Pato01010/ECE455_MAG5_captsone-project/Tests/powerboard photos/12V_TP1.JPG

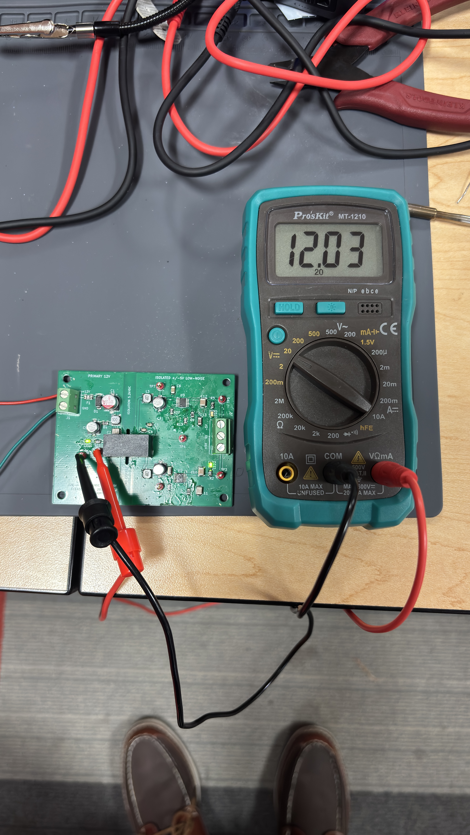
Tests/powerboard photos/12V_TP1.JPG
