Pato01010/ECE455_MAG5_captsone-project/hardware/design_files/analog_amp/magnetometer_amp.png

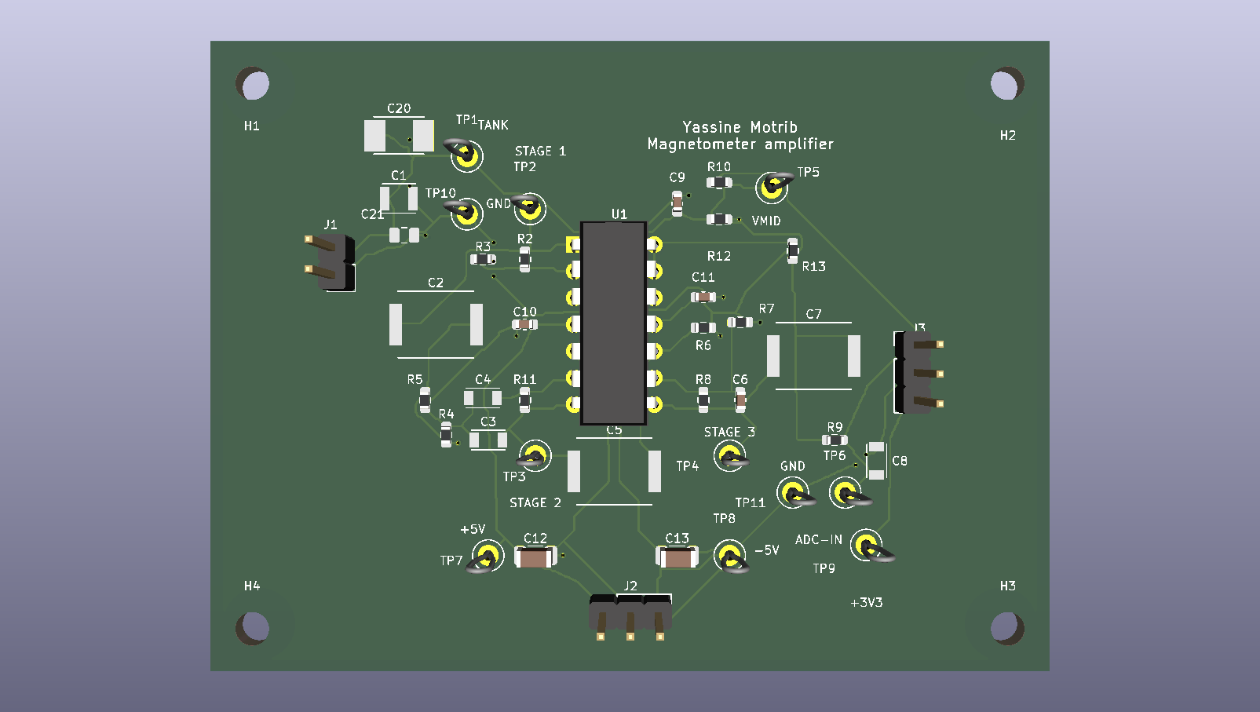
hardware/design_files/analog_amp/magnetometer_amp.png
