Pato01010/ECE455_MAG5_captsone-project/hardware/design_files/polarization_switch/polarization_switch_rev_E_3D.png

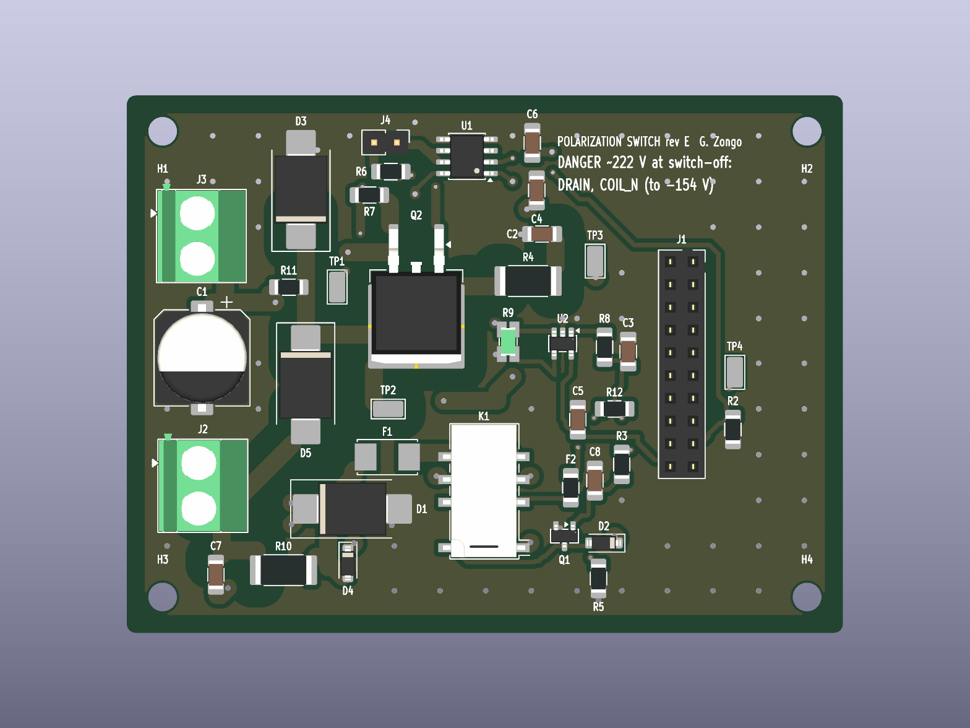
hardware/design_files/polarization_switch/polarization_switch_rev_E_3D.png
