Pato01010/ECE455_MAG5_captsone-project/hardware/design_files/power_board/MEJ2D1205SC 112V to ±5V.png

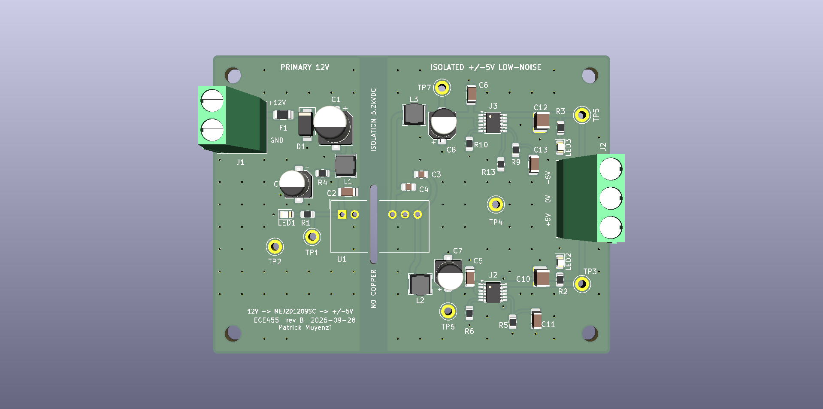
hardware/design_files/power_board/MEJ2D1205SC 112V to ±5V.png
