Pato01010/ECE455_MAG5_captsone-project/hardware/BOM/12V to ±5V converter.xlsx

Isolated ±5 V power board Rev B - bill of materials
# | References | Qty | Value | Part number | Digi-Key (qty 1)
1 | U1 | 1 | MEJ2D1209SC | MEJ2D1209SC (Murata) | 811-2407-ND
2 | U2 | 1 | LT3045 | LT3045EMSE#PBF (Analog Devices) | 505-LT3045EMSE#PBF-ND (tube, sold from 1)
3 | U3 | 1 | LT3094 | LT3094EMSE#PBF (Analog Devices) | 505-LT3094EMSE#PBF-ND (tube, sold from 1)
4 | D1 | 1 | SMAJ15A | SMAJ15A (Littelfuse) | SMAJ15ALFCT-ND
5 | LED1, LED2, LED3 | 3 | Green | LTST-C170KGKT (Lite-On) | 160-1414-1-ND
6 | C1 | 1 | 47u/50V alu | 865080645012 (Würth Elektronik) | 732-8457-1-ND
7 | C2, C11, C13 | 3 | 4.7u/25V | GRM31CR71E475KA88L (Murata) | 490-1809-1-ND
8 | C3, C4 | 2 | 1u/25V | GRM21BR71E105KA99L (Murata) | 490-6484-1-ND
9 | C5, C6 | 2 | 10u/16V | C1206C106K4RAC7215 (KEMET) | 399-C1206C106K4RAC7215CT-ND
10 | C7, C8, C9 | 3 | 22u/25V alu | UCL1E220MCL1GS (Nichicon) | 493-3932-1-ND
11 | C10, C12 | 2 | 22u/25V X7R | CL32B226KAJNNNE (Samsung) | 1276-3392-1-ND (backorder; or GRM32ER71E226KE15L, 490-5313-1-ND)
12 | L1 | 1 | 10uH | SRN4018-100M (Bourns) | SRN4018-100MCT-ND
13 | L2, L3 | 2 | 4.7uH | SRN4018-4R7M (Bourns) | SRN4018-4R7MCT-ND
14 | R1 | 1 | 4.7k | RC0805FR-074K7L (Yageo) | 311-4.70KCRCT-ND
15 | R2, R3 | 2 | 1k | RC0805FR-071KL (Yageo) | 311-1.00KCRCT-ND
16 | R4 | 1 | 0.47 | ERJ-6RQFR47V (Panasonic) | P.47DCT-ND
17 | R5, R9 | 2 | 49.9k 0.1% | ERA-6AEB4992V (Panasonic) | P49.9KDACT-ND
18 | R6 | 1 | 499 | RC0805FR-07499RL (Yageo) | 311-499CRCT-ND
19 | R10 | 1 | 3.74k | RC0805FR-073K74L (Yageo) | 311-3.74KCRCT-ND
20 | R13 | 1 | 100k | RC0805FR-07100KL (Yageo) | 311-100KCRCT-ND
21 | F1 | 1 | 0.5A PTC | SMDH1206B050TF (Yageo) | 13-SMDH1206B050TFCT-ND
22 | J1 | 1 | 12V IN | 1729128 (Phoenix Contact) | 277-1247-ND
23 | J2 | 1 | ±5V OUT | 1729131 (Phoenix Contact) | 277-1248-ND
24 | TP1-TP7 | 7 | VIN_MOD / GND / +5V / ISO_0V / -5V / +9V_F / -9V_F | 5010 (Keystone) | 36-5010-ND
