Pato01010/ECE455_MAG5_captsone-project/hardware/design_files/polarization_switch/polarization_switch_rev_E_BOM.xlsx

Polarization switch Rev E - bill of materials
# | References | Qty | Value | Part number | Digi-Key (qty 1)
1 | D1, D5 | 2 | MURS360 | MURS360-E3/57T (Vishay) | MURS360-E3/57TGICT-ND
2 | D2, D4 | 2 | 1N4148W | 1N4148W-7-F (Diodes Inc) | 1N4148W-FDICT-ND
3 | D3 | 1 | 1.5SMC200A | 1.5SMC200A (Littelfuse) | 1.5SMC200ACT-ND
4 | Q2 | 1 | R6020KNJ | R6020KNJTL (Rohm) | R6020KNJTLCT-ND
5 | Q1 | 1 | MMBT3904 | MMBT3904-7-F (Diodes Inc) | MMBT3904-FDICT-ND
6 | K1 | 1 | G6S-2F DC12 | G6S-2F DC12 (Omron) | Z889-ND (tube, sold from 1)
7 | U1 | 1 | MCP1407-E/SN | MCP1407-E/SN (Microchip) | MCP1407-E/SN-ND (tube, sold from 1)
8 | U2 | 1 | INA180A2 | INA180A2IDBVR (TI) | 296-47653-1-ND
9 | C5, C6 | 2 | 100n | C1206C104K5RACTU (KEMET) | 399-C1206C104K5RACTUCT-ND
10 | C1 | 1 | 470u/25V | EEE-FK1E471P (Panasonic) | PCE3805CT-ND
11 | C3 | 1 | 10n C0G | C1206C103J5GACTU (KEMET) | 399-C1206C103J5GACTUCT-ND
12 | C2, C7 | 2 | 1n/630V | GRM31B5C2J102JW01L (Murata) | 490-5279-1-ND
13 | C4 | 1 | 2.2u/50V | CL31B225KBHNNNE (Samsung) | 1276-1291-1-ND
14 | C8 | 1 | 10u | GRM31CR71E106KA12L (Murata) | 490-6518-1-ND
15 | R8 | 1 | 1k | RC1206FR-071KL (Yageo) | 311-1.00KFRCT-ND
16 | R6 | 1 | 47 | RMCF1206FT47R0 (Stackpole) | RMCF1206FT47R0CT-ND
17 | R2, R5, R7 | 3 | 10k | RC1206FR-0710KL (Yageo) | 311-10.0KFRCT-ND
18 | R3 | 1 | 2.2k | RC1206FR-072K2L (Yageo) | 311-2.20KFRCT-ND
19 | R9 | 1 | 20m | LVK12R020DER (Ohmite) | 273-LVK12R020DERCT-ND
20 | R4 | 1 | 10k | CRGP2512F10K (TE Connectivity) | A130733CT-ND
21 | R10 | 1 | 22k | CRGP2512F22K (TE Connectivity) | A130737CT-ND
22 | R11 | 1 | 1M | KTR18EZPF1004 (Rohm) | RHM1MAICT-ND
23 | R12 | 1 | 18 | RC1206FR-0718RL (Yageo) | 311-18.0FRCT-ND
24 | F2 | 1 | 125mA F | 0466.125NR (Littelfuse) | F1450CT-ND
25 | F1 | 1 | 2A T | 0157002.DRT (Littelfuse)
26 | J4 | 1 | GATE LINK | PREC002SAAN-RC + SPC02SYAN shunt (Sullins) | S1012EC-02-ND + S9001-ND
27 | J1 | 1 | 2x10 stack | PPPC102LFBN-RC (Sullins) | S6106-ND
28 | J2 | 1 | COIL | 1715721 (Phoenix Contact) | 277-1263-ND
29 | J3 | 1 | 12V IN | 1715721 (Phoenix Contact) | 277-1263-ND
30 | TP1-TP4 | 4 | GATE / DRAIN / SRC / I_SENSE | 5015 (Keystone) | 36-5015CT-ND
 | Line items | 30
 | Parts | 39
