Pato01010/ECE455_MAG5_captsone-project/mechanical/3D wire container/cap_fit_tight_0p2mm.stl

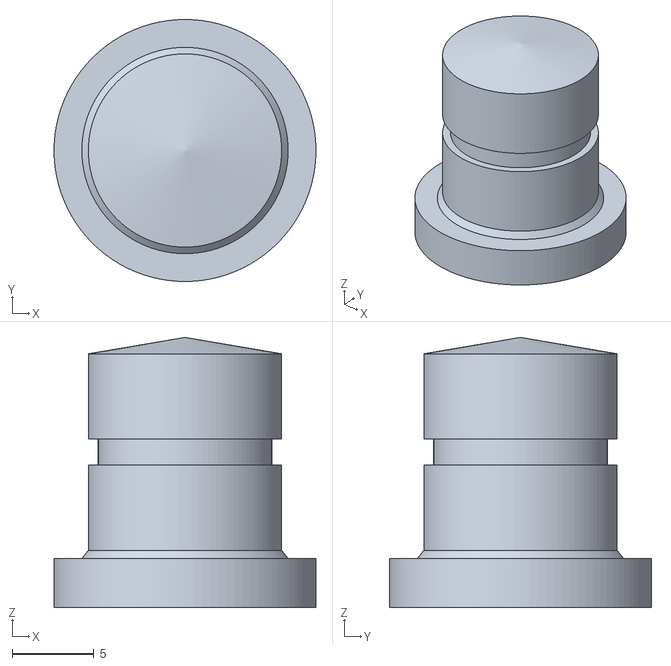
[picture p6: CAD file, 2026-10-30]
mechanical/3D wire container/cap_fit_tight_0p2mm.stl
16.0 x 16.0 x 16.5
