Pato01010/ECE455_MAG5_captsone-project/mechanical/part1_body_wide_base.stl

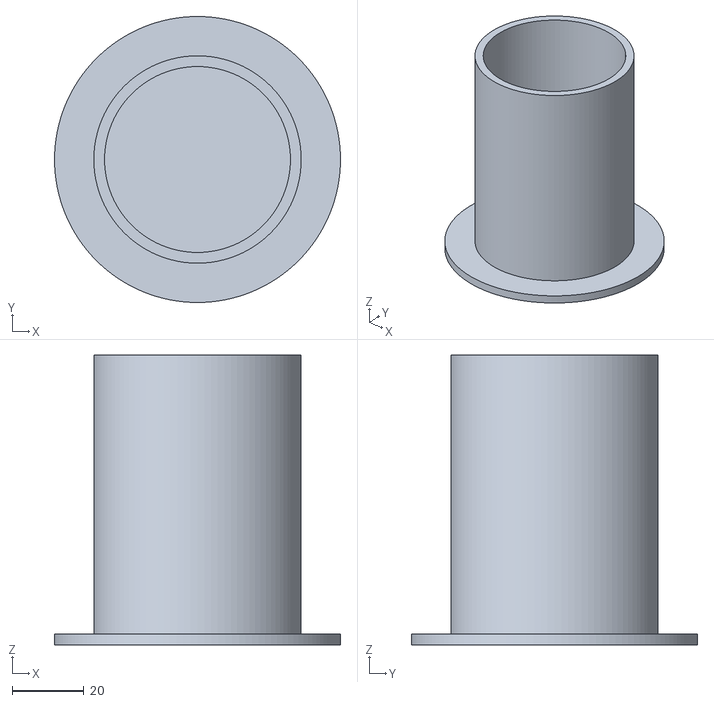
[picture p7: CAD file, 2026-10-30]
mechanical/part1_body_wide_base.stl
80.0 x 80.0 x 81.0
