Pato01010/ECE455_MAG5_captsone-project/mechanical/3D wire container/cap_fit_loose_1p4mm.stl

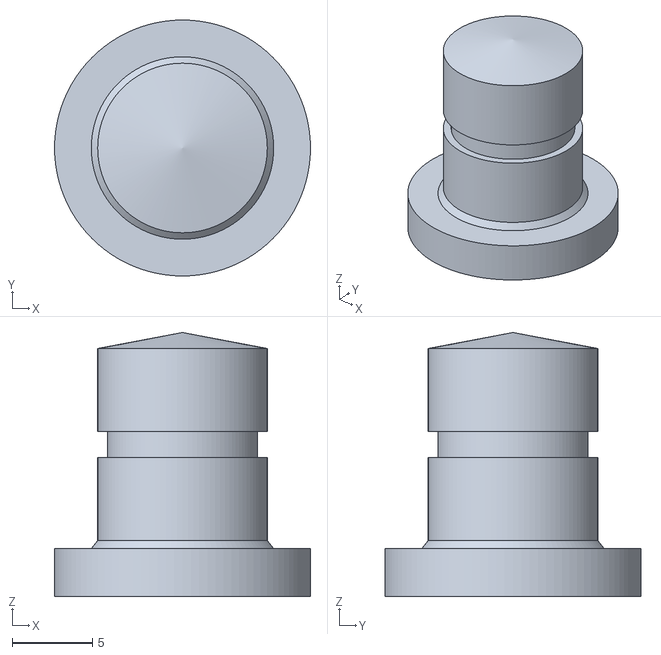
[picture p8: CAD file, 2026-10-30]
mechanical/3D wire container/cap_fit_loose_1p4mm.stl
16.0 x 16.0 x 16.5
