Pato01010/ECE455_MAG5_captsone-project/mechanical/3D wire container/part2_flat_disc_with_neck.stl

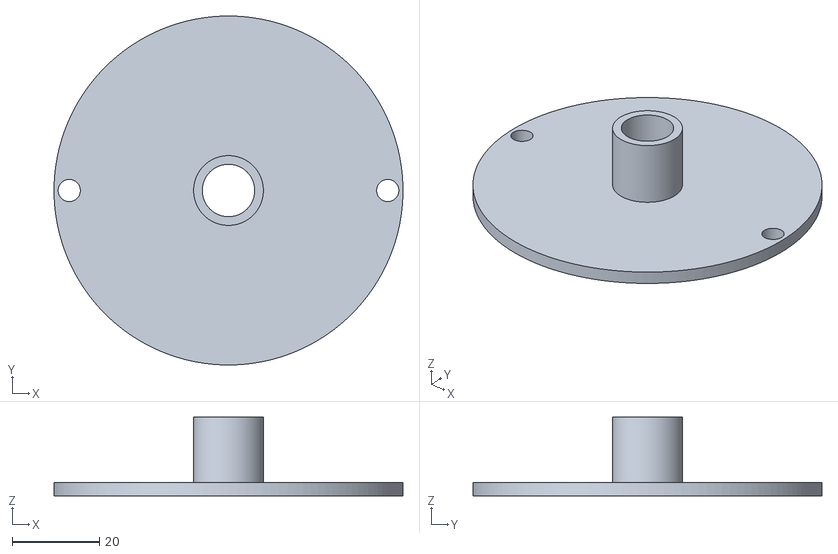
[picture p9: CAD file, 2026-10-30]
mechanical/3D wire container/part2_flat_disc_with_neck.stl
80.0 x 80.0 x 18.0
