Pato01010/ECE455_MAG5_captsone-project/(list of files, cad)

Other CAD files:
mechanical/cap_fit_medium_1p0mm.stl
mechanical/3D wire container/cap_fit_snug_0p6mm.stl
