Pato01010/ECE455_MAG5_captsone-project/Tests/powerboard photos/final assembled pcb.jpg

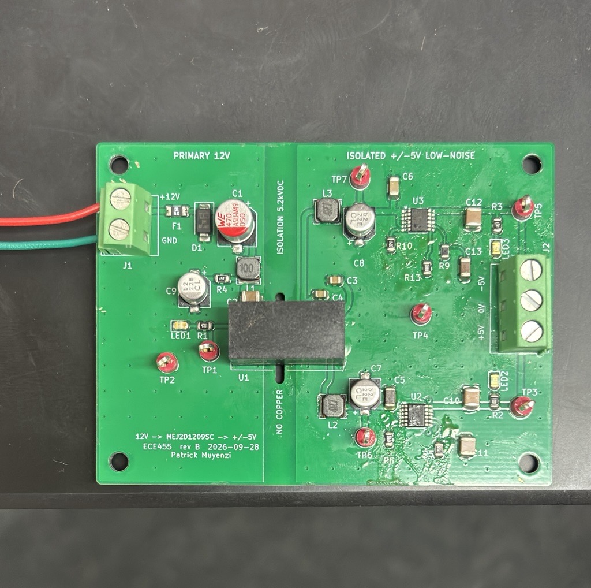
Tests/powerboard photos/final assembled pcb.jpg
