Pato01010/ECE455_MAG5_captsone-project/LTSpice Simulations/powerboard/results ±5V.png

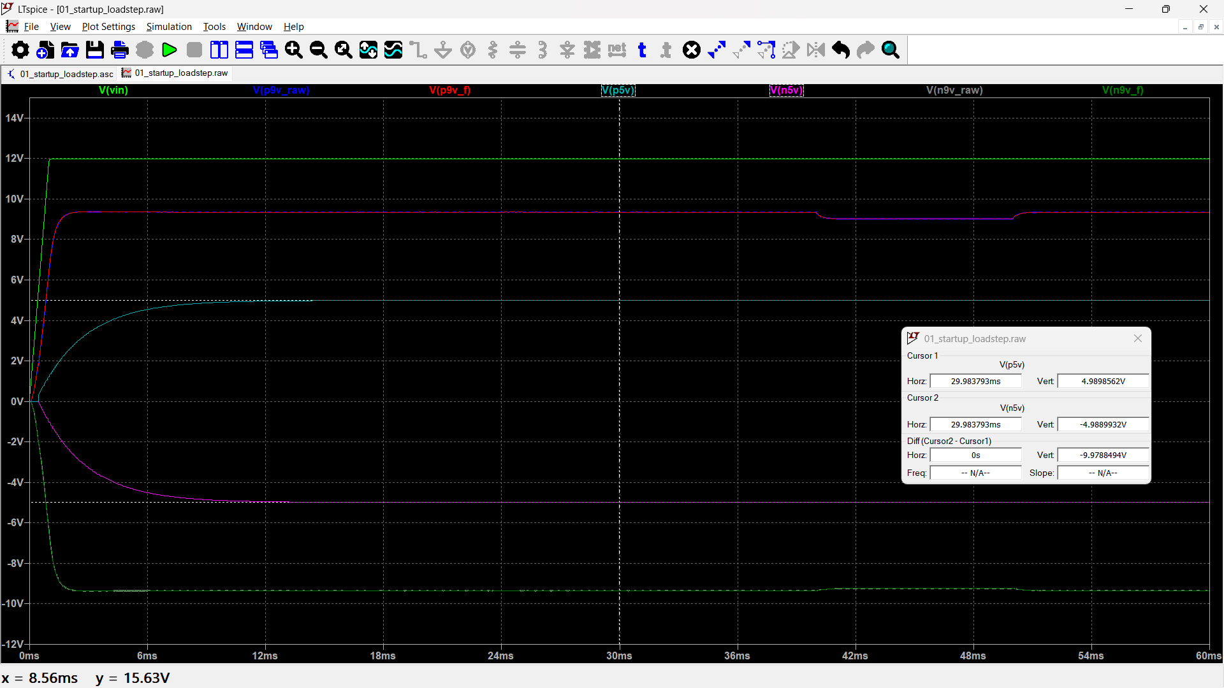
LTSpice Simulations/powerboard/results ±5V.png
