Pato01010/ECE455_MAG5_captsone-project/Tests/powerboard photos/5V_TP3.JPG

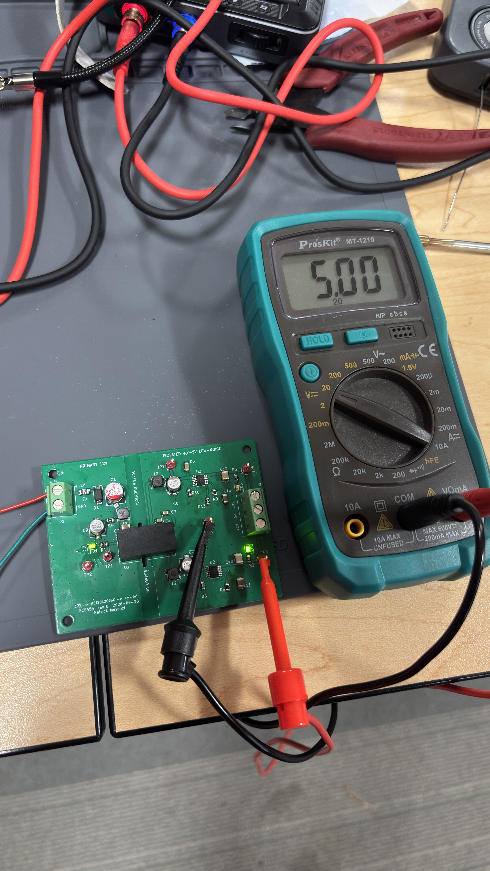
Tests/powerboard photos/5V_TP3.JPG
