Pato01010/ECE455_MAG5_captsone-project/Tests/powerboard photos/9V_TP6.JPG

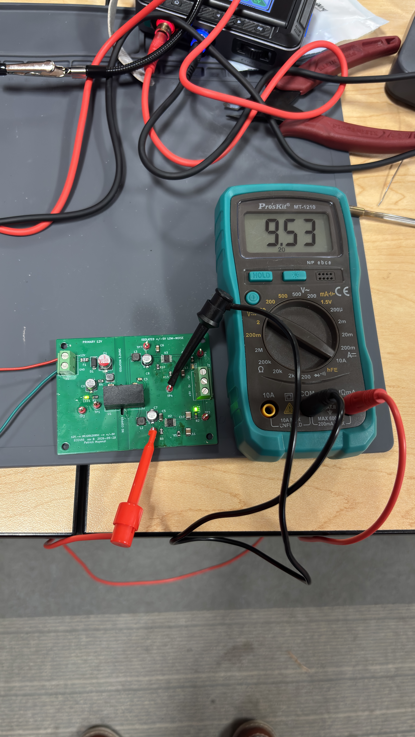
Tests/powerboard photos/9V_TP6.JPG
