Pato01010/ECE455_MAG5_captsone-project/hardware/design_files/power_board/01_startup_loadstep.asc

C1: polcap; 47µ; Rser=0.44
C2: cap; 4.7µ; Rser=5m
C3: cap; 1µ; Rser=5m
C4: cap; 1µ; Rser=5m
C5: cap; 10µ; Rser=5m
C6: cap; 10µ; Rser=5m
C7: polcap; 22µ; Rser=1.2
C8: polcap; 22µ; Rser=1.2
C9: polcap; 22µ; Rser=1.2
C10: cap; 22µ; Rser=3m
C11: cap; 47n; Rser=5m
C12: cap; 22µ; Rser=3m
C13: cap; 47n; Rser=5m
D1: diode; SMAJ15A
F1: res; 0.25
ILP: current; PULSE(0 50m 40m 1u 1u 10m) load
L1: ind; 10µ; Rser=0.14
L2: ind; 4.7µ; Rser=80m
L3: ind; 4.7µ; Rser=80m
LED1: LED; LEDG
LED2: LED; LEDG
LED3: LED; LEDG
R1: res; 4.7k
R2: res; 1k
R3: res; 1k
R4: res; 0.47
R5: res; 49.9k
R6: res; 499
R9: res; 49.9k
R10: res; 3.74k
R13: res; 100k
Riso: res; 1G
RLN: res; 100
RLP: res; 100
U1: MEJ2D1209SC
U2: LT3045
U3: LT3094
V1: voltage; PWL(0 0 1m 12); Rser=50m
Named nets: VIN, VIN_F, VIN_MOD, 0, ISO_0V, P9V_RAW, N9V_RAW, P9V_F, N9V_F, P5V, N5V
ECE455 Rev B  ·  isolated ±5 V low-noise supply
Bench 01  ·  start-up + 50 mA load step on +5 V
12 V -> pi-filter -> MEJ2D1209SC (±9 V, 5.2 kVDC) -> LC pre-filter -> LT3045 / LT3094 -> ±5 V
proton magnetometer analog front end  ·  Patrick Muyenzi
drawn by scripts/build_ltspice.py: change the script and re-run it so every bench stays in sync
NOTES
V1 ramps 0 -> 12 V in 1 ms; RLP = RLN = 100 ohm (50 mA per rail); ILP adds 50 mA on +5 V at 40-50 ms
C11 / C13 = 47 nF here so the LDOs settle fast; the board's 4.7 µF: bench 08
run it: the plot opens with every rail in one pane (01_startup_loadstep.plt)
LDO resistors from the design: R5 = R9 = 49.9k (±4.99 V), R6 = 499, R10 = 3.74k
SIMULATION
analysis
.tran 0 60m 0 100n uic
.options plotwinsize=0
.param T1=35m T2=39.5m
.lib MEJ2D12xxSC.lib
.save V(VIN) V(VIN_MOD) V(P9V_RAW) V(N9V_RAW)
+ V(P9V_F) V(N9V_F) V(P5V) V(N5V) V(ISO_0V)
+ I(V1) I(RLP) I(RLN)
steady state in the T1..T2 window: rail voltages, input power
.meas tran Vp  avg V(P5V,ISO_0V) from {T1} to {T2}
.meas tran Vn  avg V(N5V,ISO_0V) from {T1} to {T2}
.meas tran V9p avg V(P9V_F,ISO_0V) from {T1} to {T2}
.meas tran V9n avg V(N9V_F,ISO_0V) from {T1} to {T2}
.meas tran Pin  avg -V(VIN)*I(V1) from {T1} to {T2}
.meas tran Iin  avg -I(V1) from {T1} to {T2}
45 kHz ripple through the filter chain, output power, efficiency
.meas tran Vp_pp_raw pp V(P9V_RAW,ISO_0V) from {T1} to {T2}
.meas tran Vp_pp_f   pp V(P9V_F,ISO_0V) from {T1} to {T2}
.meas tran Vp_pp     pp V(P5V,ISO_0V) from {T1} to {T2}
.meas tran Vn_pp     pp V(N5V,ISO_0V) from {T1} to {T2}
.meas tran Pout avg V(P5V,ISO_0V)*I(RLP)-V(N5V,ISO_0V)*I(RLN) from {T1} to {T2}
.meas tran eff param Pout/Pin
start-up time, load step response, inrush
.meas tran t_p45 when V(P5V,ISO_0V)=4.5 rise=1
.meas tran t_n45 when V(N5V,ISO_0V)=-4.5 fall=1
.meas tran Vp_min  min V(P5V,ISO_0V) from 40m to 50m
.meas tran Vp_max  max V(P5V,ISO_0V) from 50m to 60m
.meas tran Vp_step avg V(P5V,ISO_0V) from 45m to 49.5m
.meas tran Vn_step avg V(N5V,ISO_0V) from 45m to 49.5m
.meas tran Iin_peak max -I(V1) from 0 to 10m
1  INPUT FILTER
12 V in, before the MEJ: PTC fuse, TVS clamp, LC pi-filter + R-C damper
PTC 0.5 A hold
2  ISOLATED DC-DC
MEJ2D1209SC, 5.2 kVDC
Riso = 5.2 kV barrier leakage
(only sets the sim DC reference)
3  ±9 V LC PRE-FILTER
P9V_RAW / N9V_RAW -> LDO inputs
C3 + L2 + (C5 || C7) per rail, CLC pi filter
corner 1/(2 pi sqrt(4.7µ x 32µ)) = 13 kHz,
-23 dB at the 90 kHz module ripple (bench 05)
alu C7 / C8 ESR damps the LC peak
4  LOW-NOISE LDOs
LT3045 (+5 V), LT3094 (-5 V): VOUT = 100 µA x RSET
PG n.c.
PG n.c.
5  OUTPUTS
status LEDs + test loads
LED2 / LED3: 1k + green LED, about 3 mA
RLP / RLN + ILP: simulated front-end load
