Pato01010/ECE455_MAG5_captsone-project/hardware/design_files/power_board/MEJ2D1205SC.kicad_pcb

## KiCad design hardware/design_files/power_board/MEJ2D1205SC.kicad_pcb (2026-10-23)

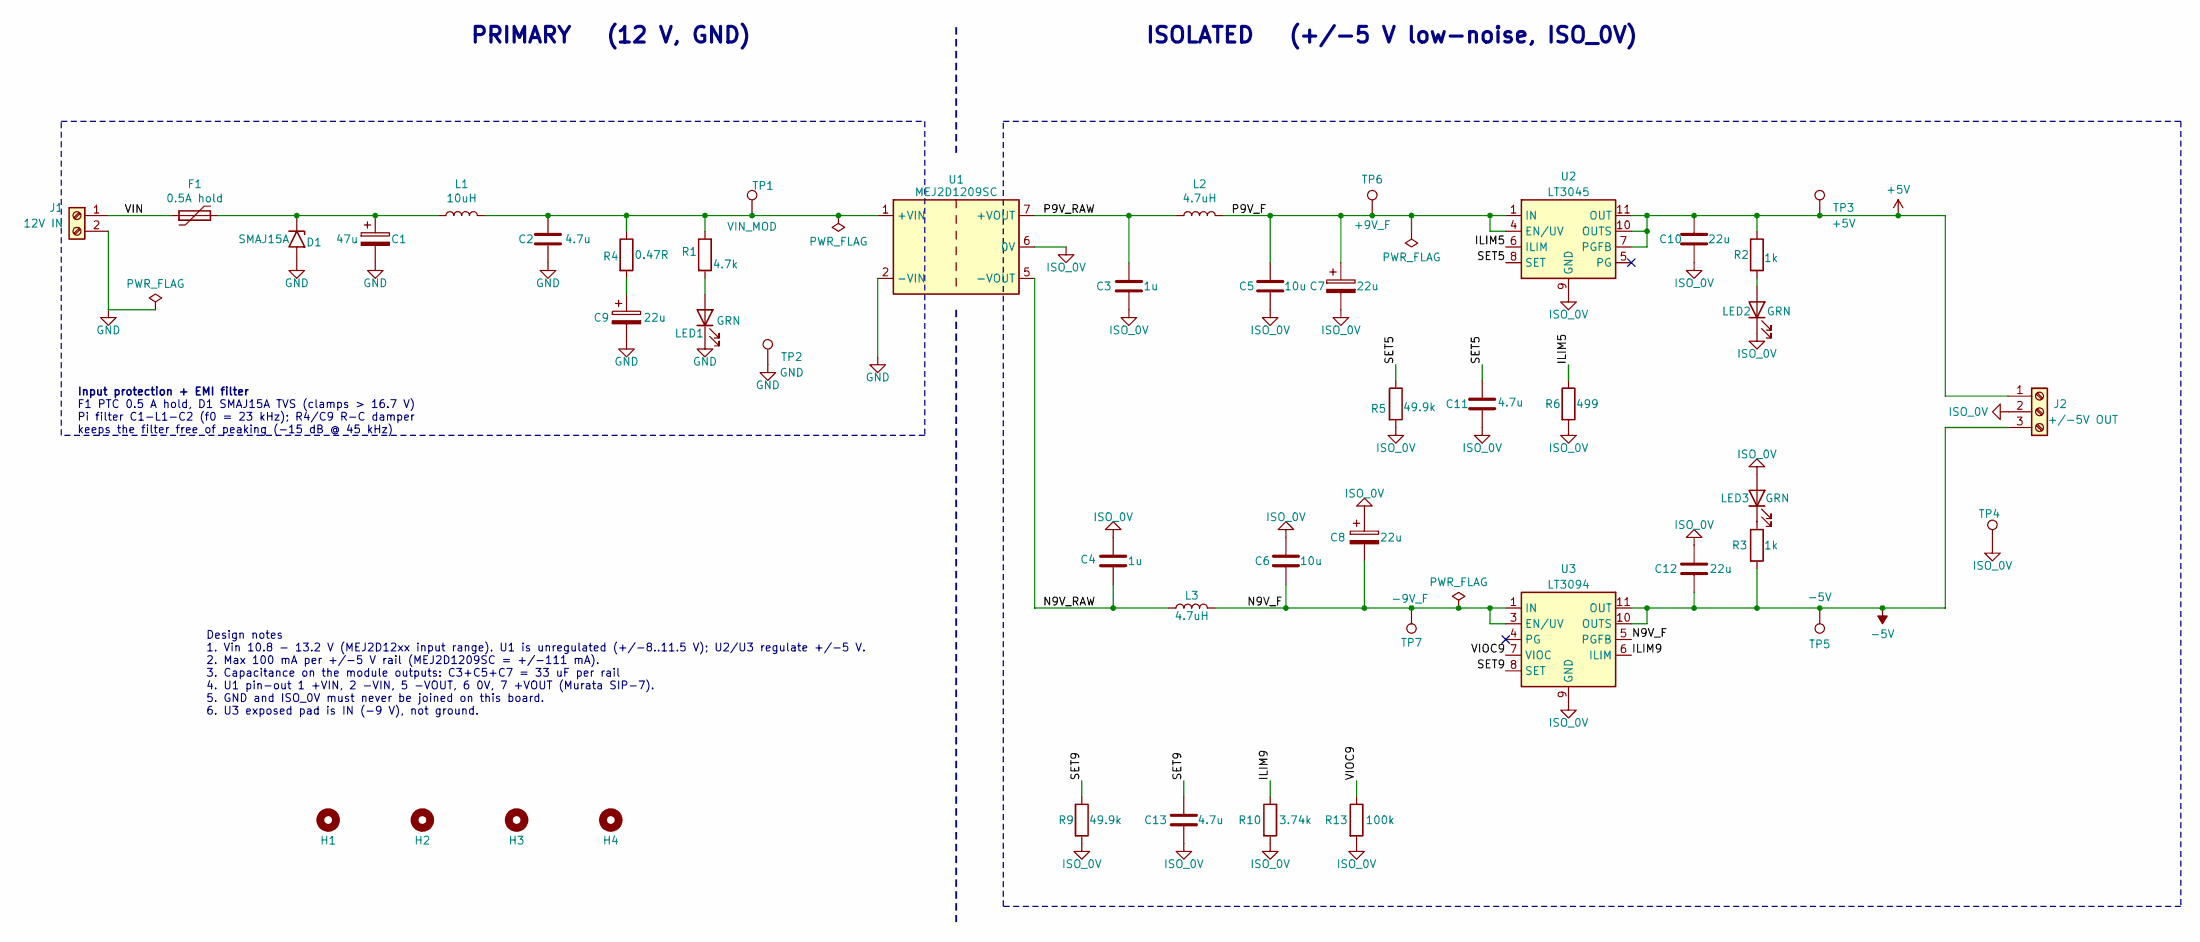
[picture p15: schematic MEJ2D1205SC.kicad_sch, Low-noise isolated 12V to +/-5V converter]

Parts:
C1: 47u; CP_Elec_6.3x7.7; MPN Panasonic EEE-FK1E470P
C2: 4.7u; C_1206_3216Metric; MPN Murata GRM31CR71E475KA88
C3, C4: 1u; C_0805_2012Metric; MPN Murata GRM21BR71C105KA01L
C5, C6: 10u; C_1206_3216Metric; MPN Murata GRM31CR71E106KA12L
C7, C8, C9: 22u; CP_Elec_5x5.8; MPN Panasonic EEE-FK1E220R
C10, C12: 22u; C_1210_3225Metric; MPN Murata GRM32ER71C226KE18L
C11, C13: 4.7u; C_1206_3216Metric; MPN Murata GRM31CR71C475KA01L
D1: SMAJ15A; D_SMA; MPN Littelfuse SMAJ15A
F1: 0.5A hold; Fuse_1206_3216Metric; MPN Littelfuse 1206L050/15YR
H1, H2, H3, H4: M3; MountingHole_3.2mm_M3
J1: 12V IN; TerminalBlock_Phoenix_MKDS-1,5-2-5.08_1x02_P5.08mm_Horizont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; MPN Phoenix Contact 1729128
J2: +/-5V OUT; TerminalBlock_Phoenix_MKDS-1,5-3-5.08_1x03_P5.08mm_Horizont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; MPN Phoenix Contact 1729131
L1: 10uH; L_Bourns-SRN4018; MPN Bourns SRN4018-100M
L2, L3: 4.7uH; L_Bourns-SRN4018; MPN Bourns SRN4018-4R7M
LED1, LED2, LED3: GRN; LED_0805_2012Metric; MPN Lite-On LTST-C171GKT
R1: 4.7k; R_0805_2012Metric; MPN Yageo RC0805FR-074K7L
R2, R3: 1k; R_0805_2012Metric; MPN Yageo RC0805FR-071KL
R4: 0.47R; R_0805_2012Metric; MPN Yageo RL0805FR-070R47L
R5, R9: 49.9k; R_0805_2012Metric; MPN Panasonic ERA-6AEB4992V
R6: 499; R_0805_2012Metric; MPN Yageo RC0805FR-07499RL
R10: 3.74k; R_0805_2012Metric; MPN Yageo RC0805FR-073K74L
R13: 100k; R_0805_2012Metric; MPN Yageo RC0805FR-07100KL
TP1: VIN_MOD; TestPoint_Keystone_5010-5014_Multipurpose; MPN Keystone 5010
TP2: GND; TestPoint_Keystone_5010-5014_Multipurpose; MPN Keystone 5011
TP3: +5V; TestPoint_Keystone_5010-5014_Multipurpose; MPN Keystone 5010
TP4: ISO_0V; TestPoint_Keystone_5010-5014_Multipurpose; MPN Keystone 5011
TP5: -5V; TestPoint_Keystone_5010-5014_Multipurpose; MPN Keystone 5010
TP6: +9V_F; TestPoint_Keystone_5010-5014_Multipurpose; MPN Keystone 5010
TP7: -9V_F; TestPoint_Keystone_5010-5014_Multipurpose; MPN Keystone 5010
U1: MEJ2D1209SC; Murata_MEJ2DxxxxSC_THT; MPN Murata MEJ2D1209SC
U2: LT3045; MSOP-12-1EP_3x4.039mm_P0.65mm_EP1.651x2.845mm; MPN Analog Devices LT3045EMSE#PBF
U3: LT3094; MSOP-12-1EP_3x4.039mm_P0.65mm_EP1.651x2.845mm; MPN Analog Devices LT3094EMSE#PBF

Connections:
+5V: C10.1, J2.1, R2.1, TP3.1 (1_1), U2.7 (PGFB), U2.10 (OUTS), U2.11 (OUT), U2.12 (OUT)
-5V: C12.2, J2.3, R3.2, TP5.1 (1_1), U3.10 (OUTS), U3.11 (OUT), U3.12 (OUT)
/ILIM5: R6.1, U2.6 (ILIM)
/ILIM9: R10.1, U3.6 (ILIM)
/N9V_F: C6.2, C8.2, L3.2, TP7.1 (1_1), U3.1 (IN), U3.2 (IN), U3.3 (EN/UV), U3.5 (PGFB), U3.13 (IN)
/N9V_RAW: C4.2, L3.1, U1.5 (-VOUT)
/P9V_F: C5.1, C7.1, L2.2, TP6.1 (1_1), U2.1 (IN), U2.2 (IN), U2.3 (IN), U2.4 (EN/UV)
/P9V_RAW: C3.1, L2.1, U1.7 (+VOUT)
/SET5: C11.1, R5.1, U2.8 (SET)
/SET9: C13.1, R9.1, U3.8 (SET)
/VIN: F1.1, J1.1
/VIOC9: R13.1, U3.7 (VIOC)
GND: C1.2, C2.2, C9.2, D1.2 (A), J1.2, LED1.1 (K), TP2.1 (1_1), U1.2 (-VIN)
ISO_0V: C3.2, C4.1, C5.2, C6.1, C7.2, C8.1, C10.2, C11.2, C12.1, C13.2, J2.2, LED2.1 (K), LED3.2 (A), R5.2, R6.2, R9.2, R10.2, R13.2, TP4.1 (1_1), U1.6 (0V), U2.9 (GND), U2.13 (GND), U3.9 (GND)
unnamed: C9.1, R4.2
unnamed: C1.1, D1.1 (K), F1.2, L1.1
unnamed: LED1.2 (A), R1.2
unnamed: LED2.2 (A), R2.2
unnamed: LED3.1 (K), R3.1
unnamed: C2.1, L1.2, R1.1, R4.1, TP1.1 (1_1), U1.1 (+VIN)

Notes on the sheet:
ISOLATED (+/-5 V low-noise, ISO_0V)
Design notes 1. Vin 10.8 - 13.2 V (MEJ2D12xx input range). U1 is unregulated (+/-8..11.5 V); U2/U3 regulate +/-5 V. 2. Max 100 mA per +/-5 V rail (MEJ2D1209SC = +/-111 mA). 3. Capacitance on the module outputs: C3+C5+C7 = 33 uF per rail 4. U1 pin-out 1 +VIN, 2 -VIN, 5 -VOUT, 6 0V, 7 +VOUT (Murata S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
F1 PTC 0.5 A hold, D1 SMAJ15A TVS (clamps > 16.7 V) Pi filter C1-L1-C2 (f0 = 23 kHz); R4/C9 R-C damper keeps the filter free of peaking (-15 dB @ 45 kHz)
PRIMARY (12 V, GND)
Input protection + EMI filter

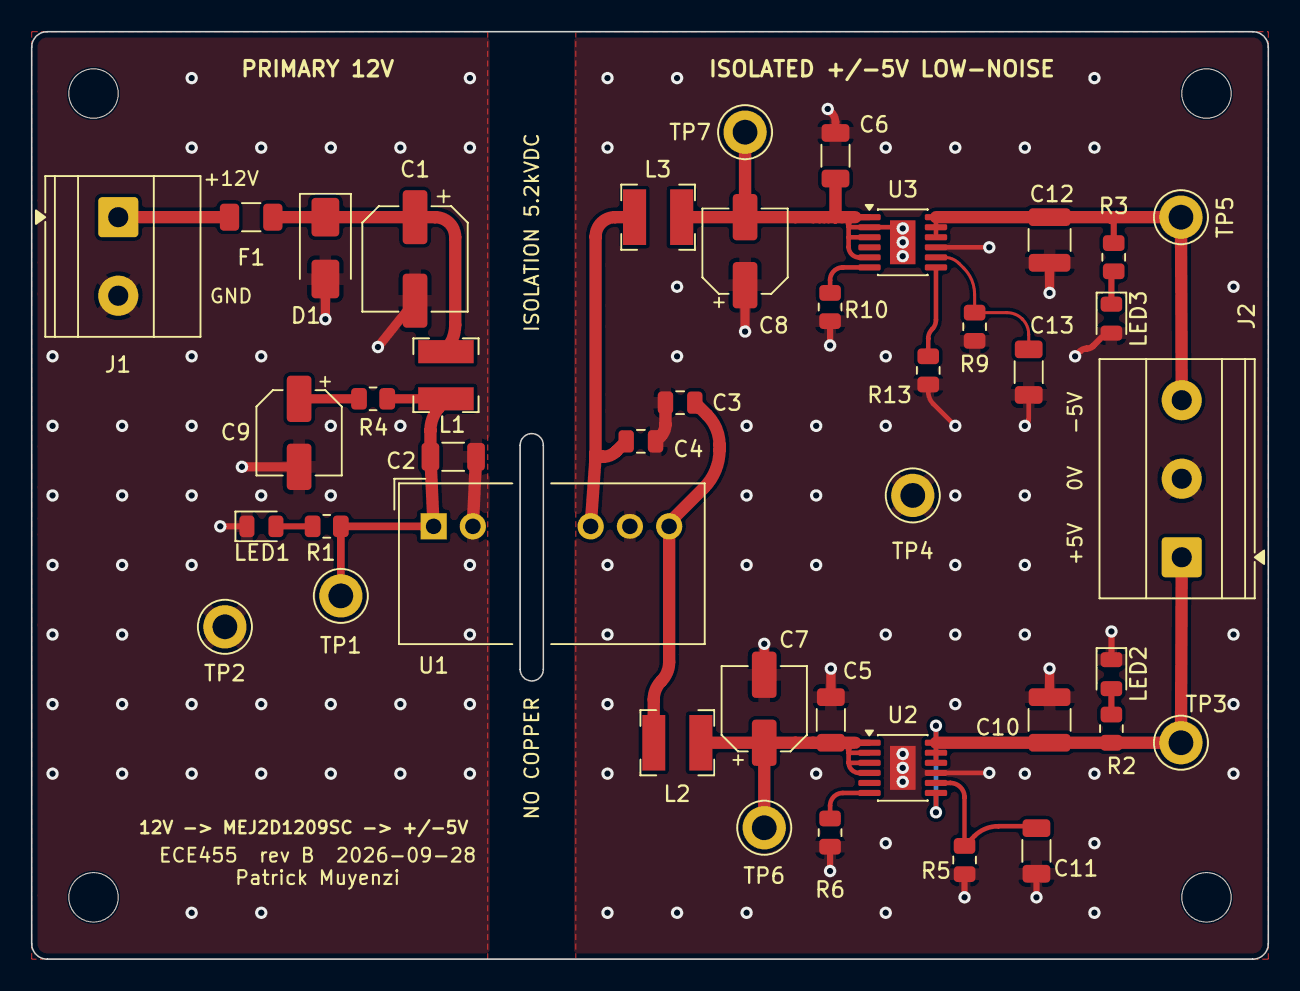
[picture p16: board MEJ2D1205SC.kicad_pcb from above]

Board: 2 copper layers, 80.0 x 60.0 mm, 46 parts (0 on the bottom side), 20 nets.
