Pato01010/ECE455_MAG5_captsone-project/hardware/design_files/polarization_switch/polarization_switch_rev_E.kicad_pcb

## KiCad design hardware/design_files/polarization_switch/polarization_switch_rev_E.kicad_pcb (2026-10-16)

Schematic: polarization_switch_rev_E.kicad_sch, Polarization switch board

Parts:
C1: 470u/25V; CP_Elec_10x10.5
C2, C7: 1n/630V; C_1206_3216Metric_Pad1.33x1.80mm_HandSolder
C3: 10n C0G; C_1206_3216Metric_Pad1.33x1.80mm_HandSolder
C4: 2.2u/50V; C_1206_3216Metric_Pad1.33x1.80mm_HandSolder
C5, C6: 100n; C_1206_3216Metric_Pad1.33x1.80mm_HandSolder
C8: 10u; C_1206_3216Metric_Pad1.33x1.80mm_HandSolder
D1, D5: MURS360; D_SMC_Handsoldering
D2, D4: 1N4148W; D_SOD-123
D3: 1.5SMC200A; D_SMC_Handsoldering
F1: 2A T; Fuseholder_Littelfuse_Nano2_157x
F2: 125mA F; Fuse_1206_3216Metric_Pad1.42x1.75mm_HandSolder
H1, H2, H3, H4: M3; MountingHole_3.2mm_M3
J1: 2x10 stack; PinSocket_2x10_P2.54mm_Vertical
J2: COIL; TerminalBlock_Phoenix_MKDS-1,5-2-5.08_1x02_P5.08mm_Horizont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
J3: 12V IN; TerminalBlock_Phoenix_MKDS-1,5-2-5.08_1x02_P5.08mm_Horizont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
J4: GATE LINK; PinHeader_1x02_P2.54mm_Vertical
K1: G6S-2F DC12; Relay_DPDT_Omron_G6S-2F
Q1: MMBT3904; SOT-23
Q2: R6020KNJ; TO-263-2
R1: R_LIM; R_Axial_Power_L48.0mm_W12.5mm_P60.96mm; not fitted
R2, R5, R7: 10k; R_1206_3216Metric_Pad1.30x1.75mm_HandSolder
R3: 2.2k; R_1206_3216Metric_Pad1.30x1.75mm_HandSolder
R4: 10k; R_2512_6332Metric_Pad1.40x3.35mm_HandSolder
R6: 47; R_1206_3216Metric_Pad1.30x1.75mm_HandSolder
R8: 1k; R_1206_3216Metric_Pad1.30x1.75mm_HandSolder
R9: 20m; R_Shunt_Ohmite_LVK12
R10: 22k; R_2512_6332Metric_Pad1.40x3.35mm_HandSolder
R11: 1M; R_1206_3216Metric_Pad1.30x1.75mm_HandSolder
R12: 18; R_1206_3216Metric_Pad1.30x1.75mm_HandSolder
TP1: GATE; TestPoint_Keystone_5015_Micro_Mini
TP2: DRAIN; TestPoint_Keystone_5015_Micro_Mini
TP3: SRC; TestPoint_Keystone_5015_Micro_Mini
TP4: I_SENSE; TestPoint_Keystone_5015_Micro_Mini
U1: MCP1407-E/SN; SOIC-8_3.9x4.9mm_P1.27mm
U2: INA180A2; SOT-23-5

Connections:
+3V3A: C5.1, J1.20, U2.5 (V+)
+12V: C1.1, C4.1, C6.1, D2.1 (K), D4.1 (K), J1.1, J1.3, J3.1, K1.1, K1.4, K1.9, R11.1, U1.1 (VDD), U1.8 (VDD)
/CMD_GATE: J1.17, R2.1, U1.2 (INPUT)
/CMD_RLY: J1.18, R3.1
/COIL_N: C7.2, D5.2 (A), J2.2, R10.2
/COIL_P: C7.1, D1.1 (K), D4.2 (A), F1.2, J2.1, R1.2, R10.1
/DRAIN: D3.1 (K), D5.1 (K), Q2.2 (D), R4.1, R11.2, TP2.1
/ISNS_N: R9.3, U2.4 (-)
/ISNS_P: R9.2, U2.3 (+)
/I_SENSE_TLMRY: C3.1, J1.11, R8.2, TP4.1
/SNUB: C2.1, R4.2
/V12_SW: F1.1, K1.5, K1.8, R1.1
/XFER: J1.13, R12.2
GND: C1.2, C2.2, C3.2, C4.2, C5.2, C6.2, C8.2, D1.2 (A), D3.2 (A), J1.2, J1.4, J1.12, J3.2, Q1.2 (E), R2.2, R5.2, R9.4, U1.4 (GND), U1.5 (GND), U2.2 (GND)
unnamed: D2.2 (A), K1.12, Q1.3 (C)
unnamed: F2.1, R12.1
unnamed: F2.2, K1.3, K1.10
unnamed: J4.1, U1.6 (OUTPUT), U1.7 (OUTPUT)
unnamed: J4.2, R6.1
unnamed: C8.1, Q1.1 (B), R3.2, R5.1
unnamed: Q2.1 (G), R6.2, R7.1, TP1.1
unnamed: Q2.3 (S), R7.2, R9.1, TP3.1
unnamed: R8.1, U2.1

Notes on the sheet:
RELAY (K1) DRIVER
POLARIZATION COIL VALUES ARE ESTIMATED
BLOCKING DIODE & DAMPING
CURRENT SENSE
CMD_RLY (bus RLY_CMD) high: K_XFER releases; K1 makes ~7 ms later (R3/C8 delay). CMD_GATE >= 30 ms later, on 2-4 s. Gate off; CMD_RLY low at +0.5 ms. K1 opens at ~+3.5 ms, its NC feeds XFER and the front end transfers the coil (~+12 ms). TUNE (+5 ms), BLANK2 (+45 ms) and the record (+60 ms) are fro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
Blocking Diodes tested and verified on PCB
GATE DRIVE
K1's NC contacts (pins 3 and 10) feed bus pin 13 (XFER, cut from GND on all four boards) through F2 (125 mA) and R12 (18 ohm) while K1 is released: ~12 V, 11-13 mA to K_XFER. F2 opens within milliseconds if pin 13 is ever left on GND. It does NOT protect 3V3D, I_SENSE or TUNE: continuity-check pins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
COIL FEED & FUSE
POLARIZATION SWITCH BOARD
REV B ADDITIONS: D4, D5, C7, R10, R11
DECOUPLING
BUS, 12 V INPUT & BULK CAP
Relay Driver tested and verified on PCB
ERC POWER FLAGS
D5 blocks the post-clamp reverse current; C7 + R10 make the swing through zero fast and damp it (C7 1 nF for up to 15 m of Belden-8760-class head cable; longer or higher-capacitance cable must be re-simulated); R11 bleeds DRAIN to +12V between shots; D4 clamps any open in the COIL_P feed.
COIL
Gate driver, MOSFET and Clamp tested and verified on PCB
REV C ADDITIONS: R12, XFER (bus pin 13)
REV E (2026-10-14): THE 80 x 60 STACK
REV D ADDITIONS (2026-10-13): SMD PARTS, 1206 MINIMUM
POWER SWITCH & CLAMP
Patrick Muyenzi's power board (isolated +/-5 V) replaces the rev C power board. This board takes its outline: 80 x 60 mm, M3 holes 4 mm in from each edge. Circuit = rev D plus J3, the 12 V input (Phoenix MKDS 1,5/2-5,08, beside Patrick's J1). The bus moved to x 62 mm; pins 1/3 carry 12 V up to the 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
XFER
K1 is an Omron G6S-2F (SMD, both poles in parallel); R3/C8 delay its make so K_XFER is back on NC first (interlock margin 6.1 ms, simulated). F1, an on-board NANO2 2 A slow-blow fuse in a clip, replaces J3 and the in-line fuse. F2 + R12 replace the fusible NFR25. R9 is a four-terminal Kelvin shunt 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
SEQUENCE (fixed delays, never timed on I_SENSE)
DRAIN reaches ~222 V at switch-off and COIL_N swings from +223 V to -154 V (D5 holds up to ~347 V between them). DRAIN, COIL_N and SNUB are in net class HV; keep XFER >= 1.25 mm from all three.
MOUNTING HOLES
NOTES
HIGH VOLTAGE
Rev C coil, COMPUTED, PROVISIONAL: 690 t of 22 AWG as two counter-wound 345 t halves in series (2.75 in acrylic tubes, water in both): ~11.3 mH, 8.3 ohm (9.6 hot), C_p 0.14-0.59 nF, ~4.0 mT/A. From 12 V: ~1.3 A cold / 1.1 A hot (1.19 / 1.03 A through 15 m of head cable).

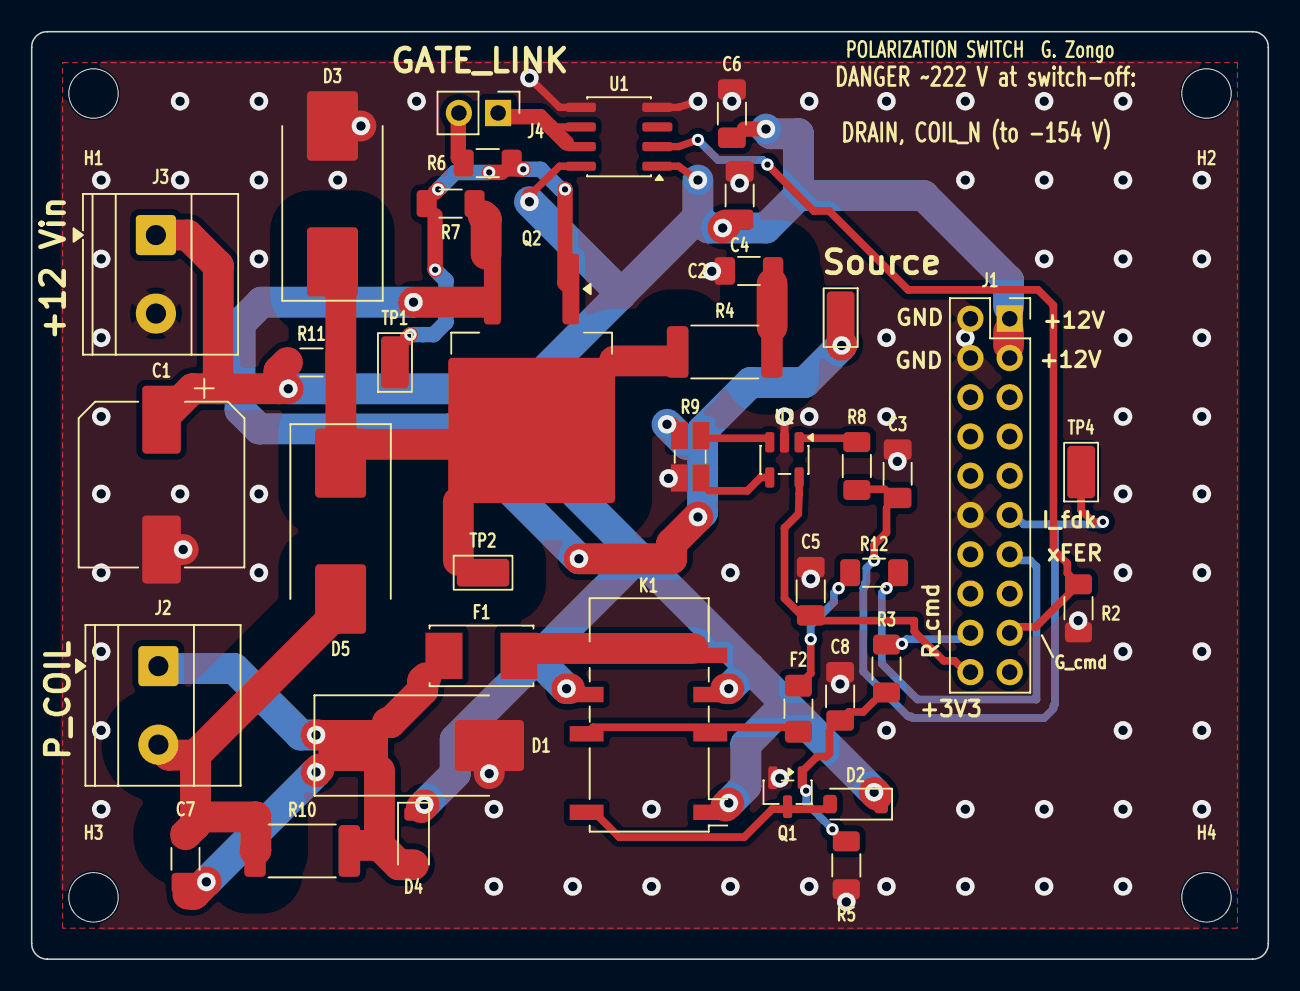
[picture p17: board polarization_switch_rev_E.kicad_pcb from above]

Board: 2 copper layers, 80.0 x 60.0 mm, 43 parts (0 on the bottom side), 23 nets.
