Pato01010/ECE455_MAG5_captsone-project/hardware/design_files/analog_amp/magnetometer_amp.kicad_pcb

## KiCad design hardware/design_files/analog_amp/magnetometer_amp.kicad_pcb (2026-10-30)

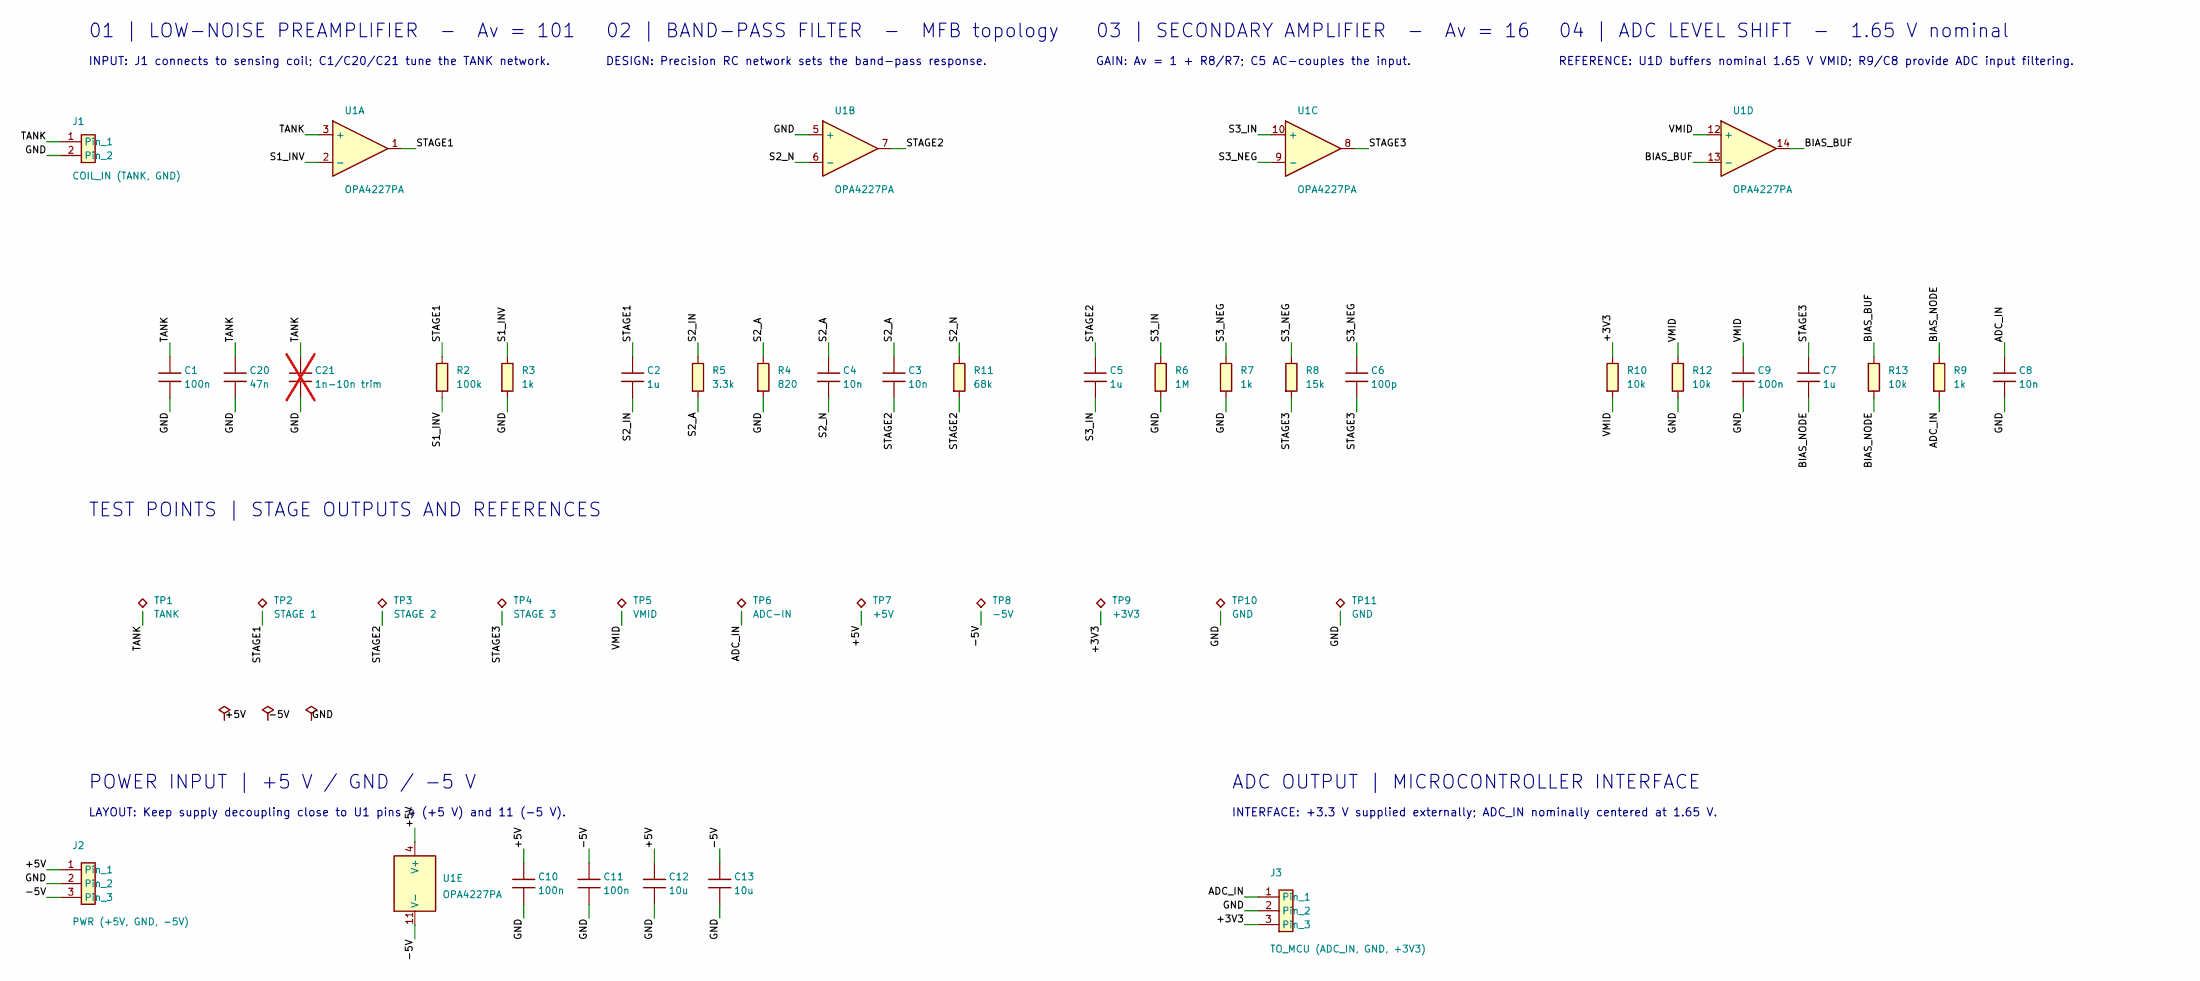
[picture p18: schematic magnetometer_amp_presentation_clean.kicad_sch, Proton-Precession Magnetometer | Analog Front End]

Parts:
C1: 100n; C1_Film_ECH_U1C104JX5; MPN ECH-U1C104JX5
C2: 1u; C2_Film_SMDIC04100TB00KQ00; MPN SMDIC04100TB00KQ00
C3: 10n; C3_Film_ECH_U1H103GX5; MPN ECH-U1H103GX5
C4: 10n; C4_Film_ECH_U1H103GX5; MPN ECH-U1H103GX5
C5: 1u; C5_Film_SMDIC04100TB00KQ00; MPN SMDIC04100TB00KQ00
C6: 100p; C6_C_0603_1608Metric
C7: 1u; C7_Film_SMDIC04100TB00KQ00; MPN SMDIC04100TB00KQ00
C8: 10n; C8_Film_ECH_U1H103GX5; MPN ECH-U1H103GX5
C9: 100n; C9_C_0603_1608Metric
C10: 100n; C10_C_0603_1608Metric
C11: 100n; C11_C_0603_1608Metric
C12: 10u; C12_C_1206_3216Metric
C13: 10u; C13_C_1206_3216Metric
C20: 47n; C20_Film_ECH_U1H473JX9; MPN ECH-U1H473JX9
C21: 1n-10n trim; C21_C_0805_2012Metric; not fitted
J1: COIL_IN (TANK, GND); J1_PinHeader_1x02_P2.54mm_Vertical
J2: PWR (+5V, GND, -5V); J2_PinHeader_1x03_P2.54mm_Vertical
J3: TO_MCU (ADC_IN, GND, +3V3); J3_PinHeader_1x03_P2.54mm_Vertical
R2: 100k; R2_R_0603_1608Metric
R3: 1k; R3_R_0603_1608Metric
R4: 820; R4_R_0603_1608Metric
R5: 3.3k; R5_R_0603_1608Metric
R6: 1M; R6_R_0603_1608Metric
R7: 1k; R7_R_0603_1608Metric
R8: 15k; R8_R_0603_1608Metric
R9: 1k; R9_R_0603_1608Metric
R10: 10k; R10_R_0603_1608Metric
R11: 68k; R11_R_0603_1608Metric
R12: 10k; R12_R_0603_1608Metric
R13: 10k; R13_R_0603_1608Metric
TP1: TANK; TP1_TestPoint_Loop_D2.50mm_Drill1.0mm
TP2: STAGE 1; TP2_TestPoint_Loop_D2.50mm_Drill1.0mm
TP3: STAGE 2; TP3_TestPoint_Loop_D2.50mm_Drill1.0mm
TP4: STAGE 3; TP4_TestPoint_Loop_D2.50mm_Drill1.0mm
TP5: VMID; TP5_TestPoint_Loop_D2.50mm_Drill1.0mm
TP6: ADC-IN; TP6_TestPoint_Loop_D2.50mm_Drill1.0mm
TP7: +5V; TP7_TestPoint_Loop_D2.50mm_Drill1.0mm
TP8: -5V; TP8_TestPoint_Loop_D2.50mm_Drill1.0mm
TP9: +3V3; TP9_TestPoint_Loop_D2.50mm_Drill1.0mm
TP10: GND; TP10_TestPoint_Loop_D2.50mm_Drill1.0mm
TP11: GND; TP11_TestPoint_Loop_D2.50mm_Drill1.0mm
U1: OPA4227PA; U1_DIP-14_W7.62mm

Connections:
/+3V3: J3.3, R10.1, TP9.1
/+5V: C10.1, C12.1, J2.1, TP7.1, U1.4 (V+)
/-5V: C11.1, C13.1, J2.3, TP8.1, U1.11 (V-)
/ADC_IN: C8.1, J3.1, R9.2, TP6.1
/BIAS_BUF: R13.1, U1.13 (-), U1.14
/BIAS_NODE: C7.2, R9.1, R13.2
/GND: C1.2, C8.2, C9.2, C10.2, C11.2, C12.2, C13.2, C20.2, C21.2, J1.2, J2.2, J3.2, R3.2, R4.2, R6.2, R7.2, R12.2, TP10.1, TP11.1, U1.5 (+)
/S1_INV: R2.2, R3.1, U1.2 (-)
/S2_A: C3.1, C4.1, R4.1, R5.2
/S2_IN: C2.2, R5.1
/S2_N: C4.2, R11.1, U1.6 (-)
/S3_IN: C5.2, R6.1, U1.10 (+)
/S3_NEG: C6.1, R7.1, R8.1, U1.9 (-)
/STAGE1: C2.1, R2.1, TP2.1, U1.1
/STAGE2: C3.2, C5.1, R11.2, TP3.1, U1.7
/STAGE3: C6.2, C7.1, R8.2, TP4.1, U1.8
/TANK: C1.1, C20.1, C21.1, J1.1, TP1.1, U1.3 (+)
/VMID: C9.1, R10.2, R12.1, TP5.1, U1.12 (+)

Notes on the sheet:
REFERENCE: U1D buffers nominal 1.65 V VMID; R9/C8 provide ADC input filtering.
LAYOUT: Keep supply decoupling close to U1 pins 4 (+5 V) and 11 (-5 V).
INTERFACE: +3.3 V supplied externally; ADC_IN nominally centered at 1.65 V.
02 | BAND-PASS FILTER - MFB topology
04 | ADC LEVEL SHIFT - 1.65 V nominal
INPUT: J1 connects to sensing coil; C1/C20/C21 tune the TANK network.
GAIN: Av = 1 + R8/R7; C5 AC-couples the input.
01 | LOW-NOISE PREAMPLIFIER - Av = 101
03 | SECONDARY AMPLIFIER - Av = 16
DESIGN: Precision RC network sets the band-pass response.
TEST POINTS | STAGE OUTPUTS AND REFERENCES
POWER INPUT | +5 V / GND / -5 V
ADC OUTPUT | MICROCONTROLLER INTERFACE

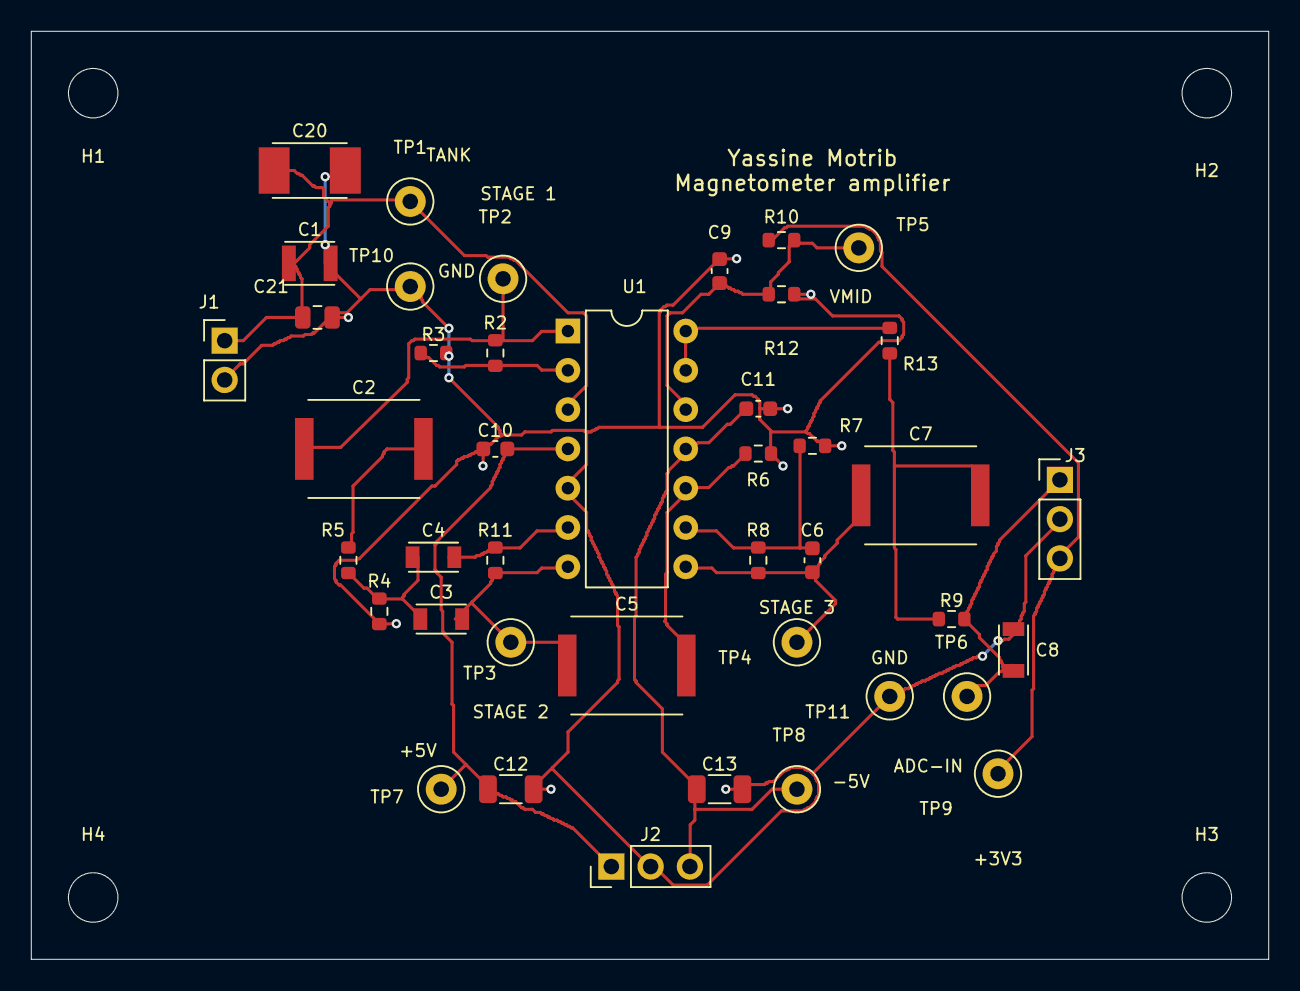
[picture p19: board magnetometer_amp.kicad_pcb from above]

Board: 2 copper layers, 80.0 x 60.0 mm, 46 parts (0 on the bottom side), 18 nets.

Other parts of the board:
H1: H1_MountingHole_3.2mm_M3
H2: H2_MountingHole_3.2mm_M3
H3: H3_MountingHole_3.2mm_M3
H4: H4_MountingHole_3.2mm_M3
