Pato01010/ECE455_MAG5_captsone-project/(commit log)

2026-10-16 project structure + pcb gerber files
2026-10-23 addec converter BOM
2026-10-23 i added pcb files from Kicad to the design files folder
2026-10-23 firmware + enclosure 3D render
2026-10-30 Add README for analog amplifier design
    This README provides an overview of the analog amplifier design for a Proton-Precession Magnetometer, including its purpose, architecture, folder guide, prototype status, important caveats, and next validation steps.
2026-10-30 Delete pending verification note from README
    Remove note about Gerber and drill outputs pending verification.
2026-10-30 Added files Kicad schematics and gerber files
2026-10-30 BOM edit
2026-10-30 created folder for the 3D wire enclosure in mechanical
2026-11-06 powerboard LTSpice simulation
2026-11-11 added powerboard ltspice simulations
